salmanfaris-bit/NOXIS-Q-Quadruped-Robot/NOXIS-Q Quad Robot/images/side view.jpeg

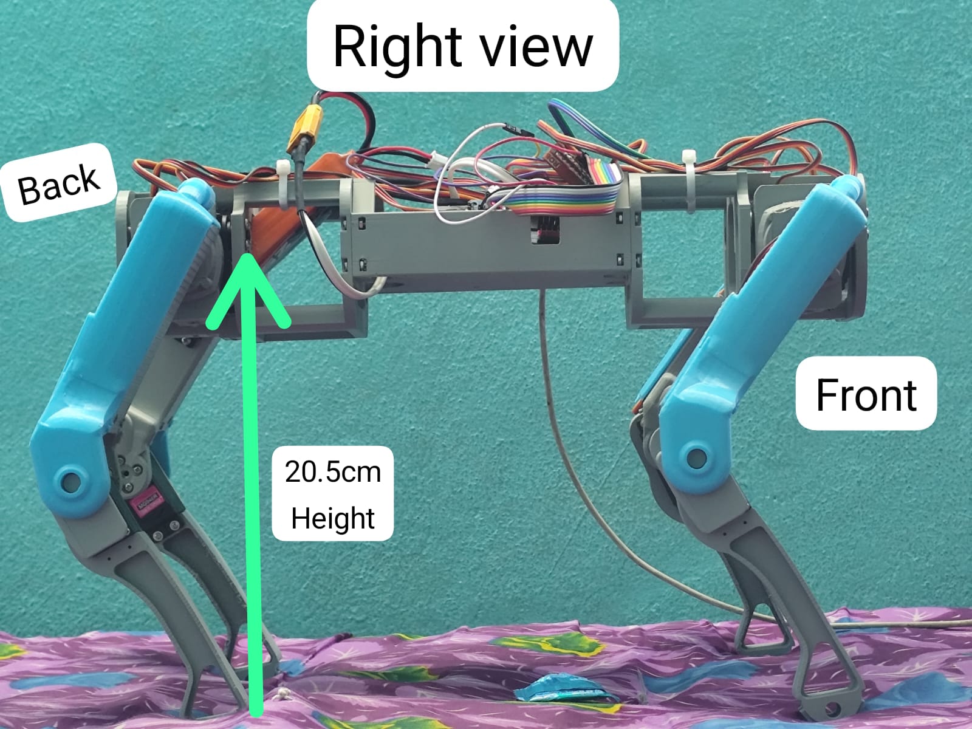
NOXIS-Q Quad Robot/images/side view.jpeg
