salmanfaris-bit/NOXIS-Q-Quadruped-Robot/NOXIS-Q Quad Robot/images/side Full stretch.jpeg

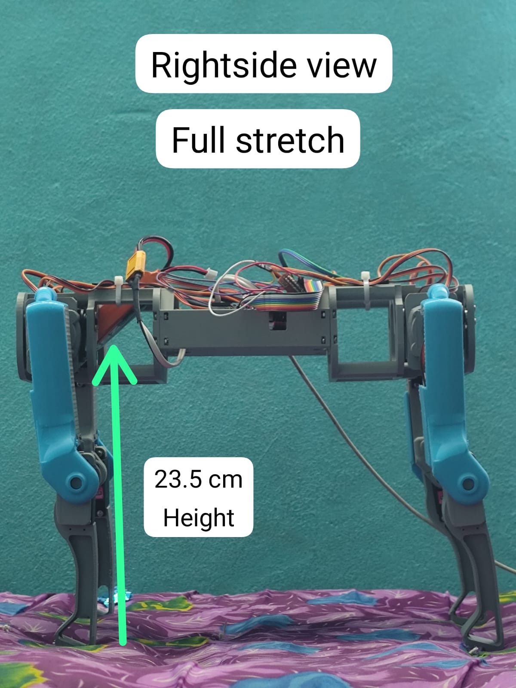
NOXIS-Q Quad Robot/images/side Full stretch.jpeg
