salmanfaris-bit/NOXIS-Q-Quadruped-Robot/NOXIS-Q Quad Robot/images/Front Full stretch.jpeg

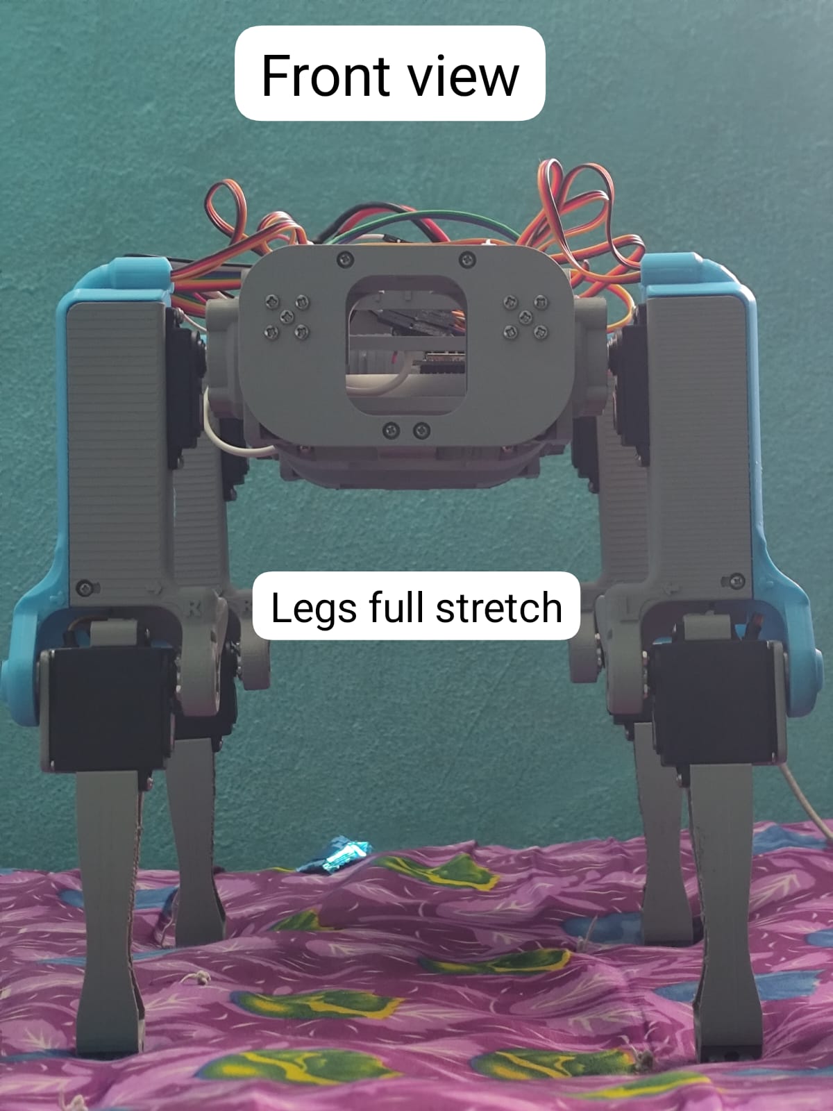
NOXIS-Q Quad Robot/images/Front Full stretch.jpeg
