salmanfaris-bit/NOXIS-Q-Quadruped-Robot/NOXIS-Q Quad Robot/images/Front.jpeg

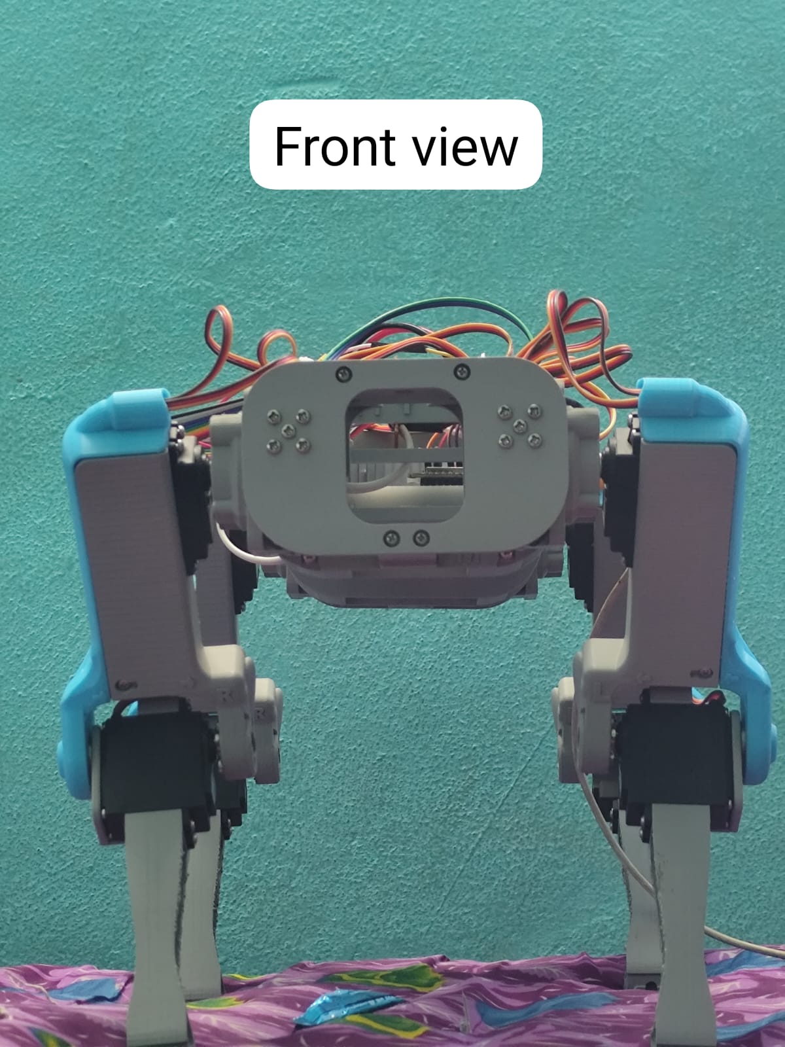
NOXIS-Q Quad Robot/images/Front.jpeg
