salmanfaris-bit/NOXIS-Q-Quadruped-Robot/NOXIS-Q Quad Robot/images/Quad Dog.jpeg

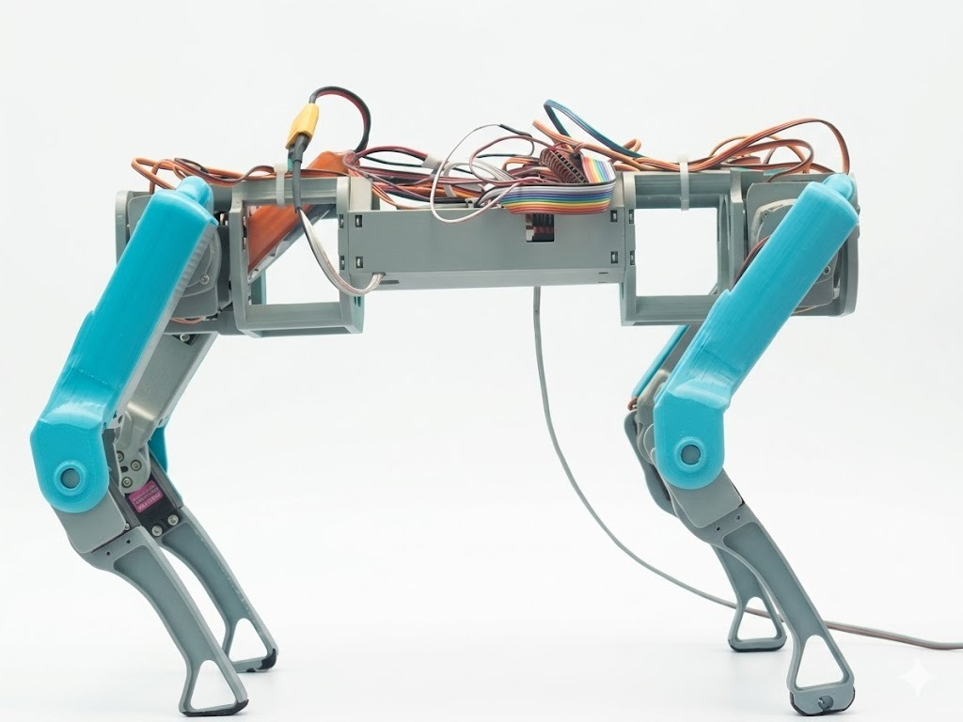
NOXIS-Q Quad Robot/images/Quad Dog.jpeg
